GarethDaviesLondon/PWM-Charge-Controller-Arduino/Schematic_PWM-Solar-Controller.pdf

### VCC SOLAR

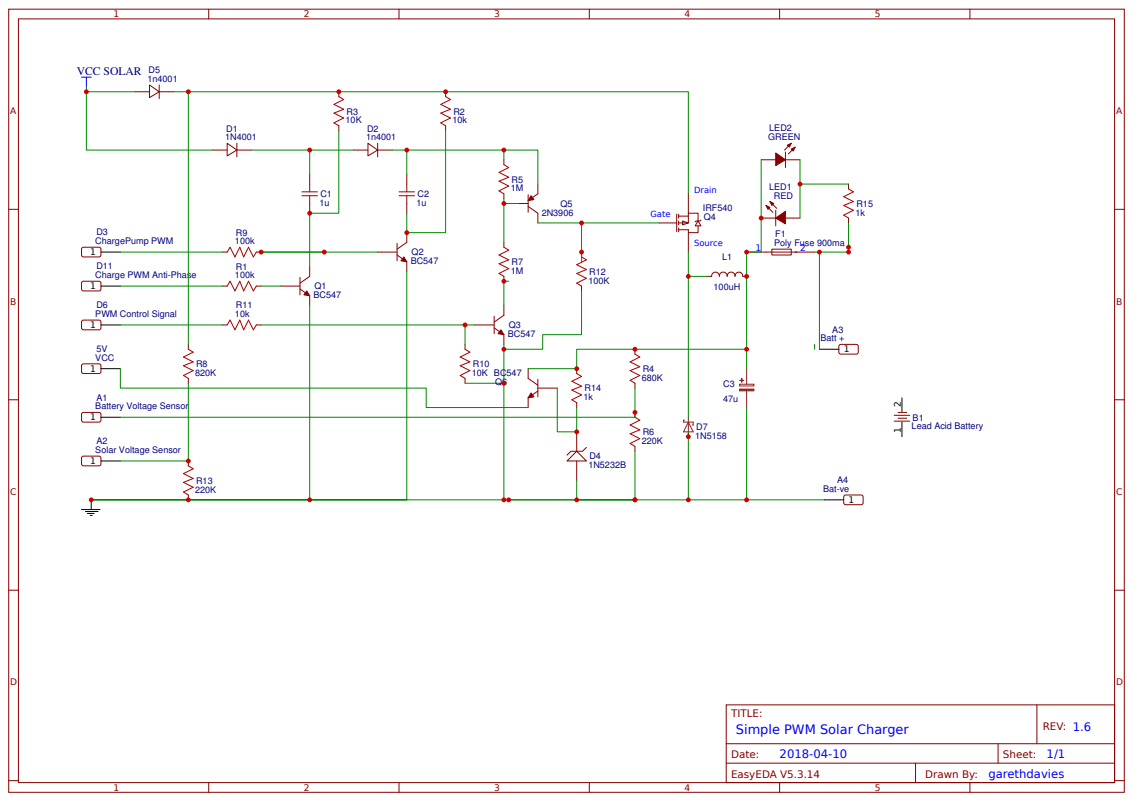
[picture p1: page 1]
