GarethDaviesLondon/PWM-Charge-Controller-Arduino/(commit log)

2018-04-10 Analogu write and inverter setup
    Adds the analogue writes on via Timer 2. Setting one pin to inverting mode of the other.
    [PWM_Charge_Controller.ino]
2018-04-10 Added a PWM blink on pin 8
    Adds a control signal for the circuit
2018-04-10 Change to Hardware Schematic
    Fixed problem of not turning off when power removed. Now uses a PNP-NPN driver circuit to trigger the control MOSFET
2018-04-10 Tidy and got MOSFET right
    MOSFET now drawn correctly. Rest of diagram tidied up and some values of resistors changed.
2018-04-10 Solar voltage sensor resistor change
    changed the solar potential divider to 820K
    Range now at 23V = 23*220/(220+820)
    i.e. 4.8 v
    check the open circuit voltage of the solar panel is not more than this, otherwise adjust R8.
2018-04-12 Implement charge controller class
    creates a class for highside
2018-04-12 Start of adding PWM Class
    Adds the PWM Class
2018-04-12 Added Voltage Sensor Class
    This now has the voltage sensor class implemented
2018-04-12 Implemented Class ChargePWM
    Implemented the class ChargePWM in a simple way. The trickle algorithm is not really too smart but does enable some testing.
2018-04-12 Testing of the VoltageSensor Class
    Simple bit of code to check that the VoltageSensor Class functions as expected.
2018-04-13 First working Charge Circuit
    This is now tested with battery and bench powersupply and seems to work fine.
2018-04-13 Has basic solar checking
    Implemented solar comparison and then goes to sleep for a bit. Very simple sleep mode just powers down the PWM waveforms.
2018-04-13 updates to values + new circuit
    major change is the circuit has a uck converter in it now which helps with the charging control
2018-04-13 correction to voltage sensor
    Corrected the battery voltage sensor in the diagram. and made the layout a bit prettier.
2018-04-13 Tuning after testing
    some tuning of parameters and added an output reverse protection diode to stop battery drain in off mode
    [PWMLibs.cpp, PWM_Charge_Controller.h]
2018-04-13 More code comments
    More code comments to finish off this stage of the project. Looks like a working unit on the test bench.
2018-04-13 corrected the output capacitor
    Drawing error on the circuit diagram corrected.
2018-04-28 small circuit updates
    Added clean up of wiring diagram and created a Test programme to help debug the hardware. Included a notes file for wiring and others
2018-04-28 Updated Schematic Diagram
    Now includes 5V Regulation to power the Arduino and a protection circuit with a Polyfuse and a couple of LED's to tell you when it's popped.
2018-04-28 Added Morse Code Output
    Fed up with having to connect the lap top to know what the unit was doing, wrote a little optical morse-code generator.
    On reset it reads out the battery and solar voltages, during operation it says in which loop it is in. (On, Off, PWM, HYST)
    [PWMLibs.cpp, PWMLibs.h, PWM_Charge_Controller.ino]
2018-04-29 Some tweaks around reporting
    Some tweeks around reporting, so that sensing the voltage doesn't send "off" and shortened the code for state. PWM is now preceded with a few flashes and the PWM waveform value reported, more use I think
    [PWMLibs.cpp, PWMLibs.h, PWM_Charge_Controller.h, PWM_Charge_Controller.ino]
